kbcola/linetracer_D4/makeTracer/circuit/sensorgensun.pdf

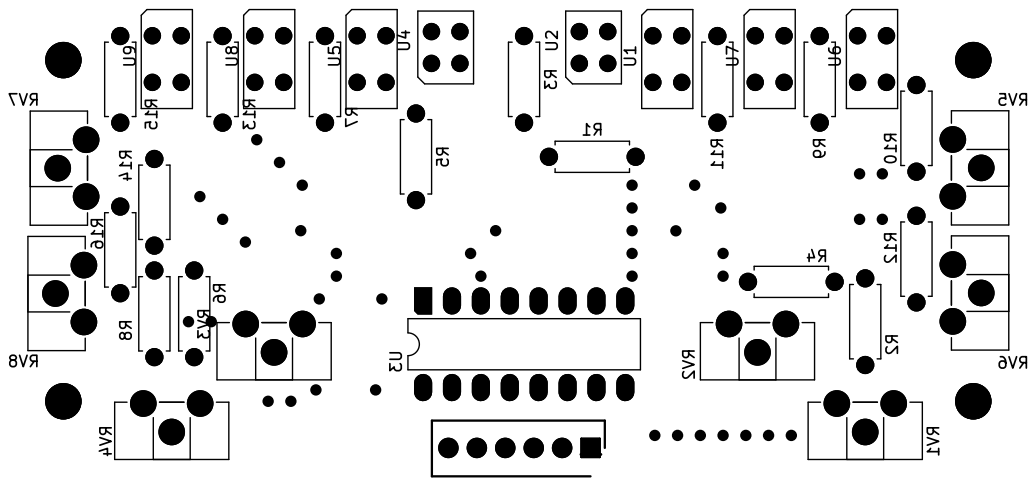
[picture p1: page 1]
