kbcola/linetracer_D4/makeTracer/circuit/factoryData/maincircuit.pdf

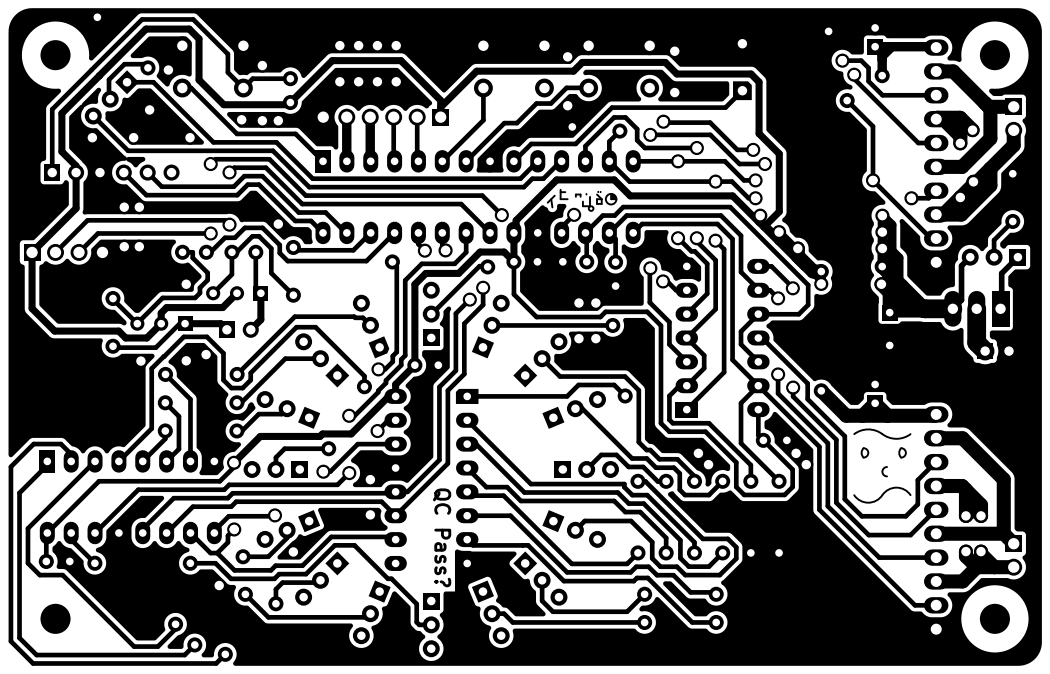
[picture p2: page 1]
