kbcola/linetracer_D4/makeTracer/circuit/factoryData/sensorcircuit.pdf

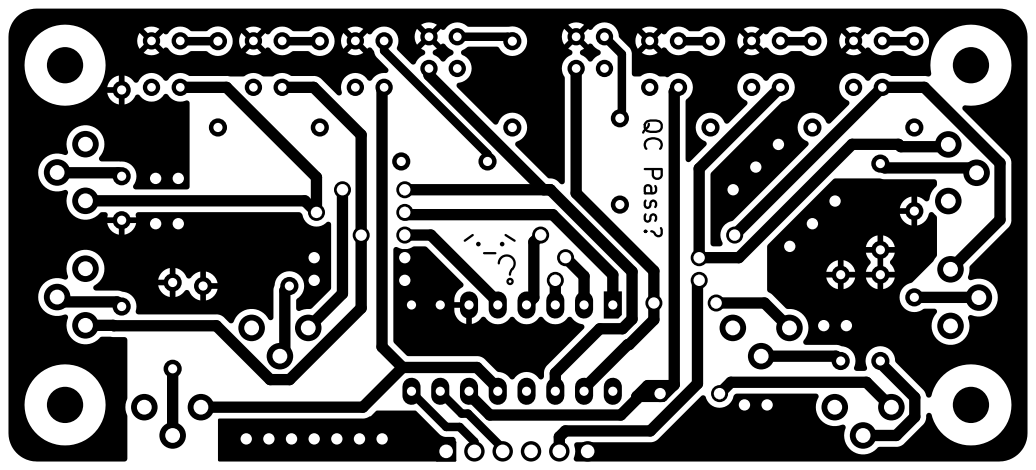
[picture p3: page 1]
