kbcola/linetracer_D4/makeTracer/circuit/maincircuit/output.pdf

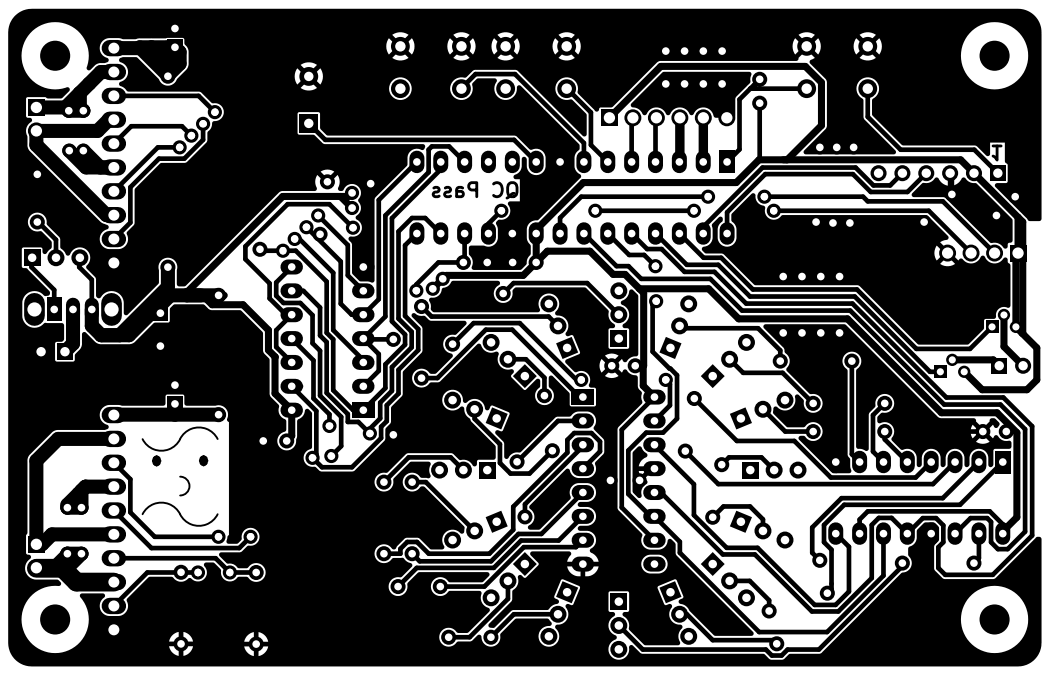
[picture p4: page 1]
