kbcola/linetracer_D4/makeTracer/circuit/sregtest/sregtest.kicad_pcb

## KiCad design Hardware/arcus_detector/arcus_detector.kicad_sch

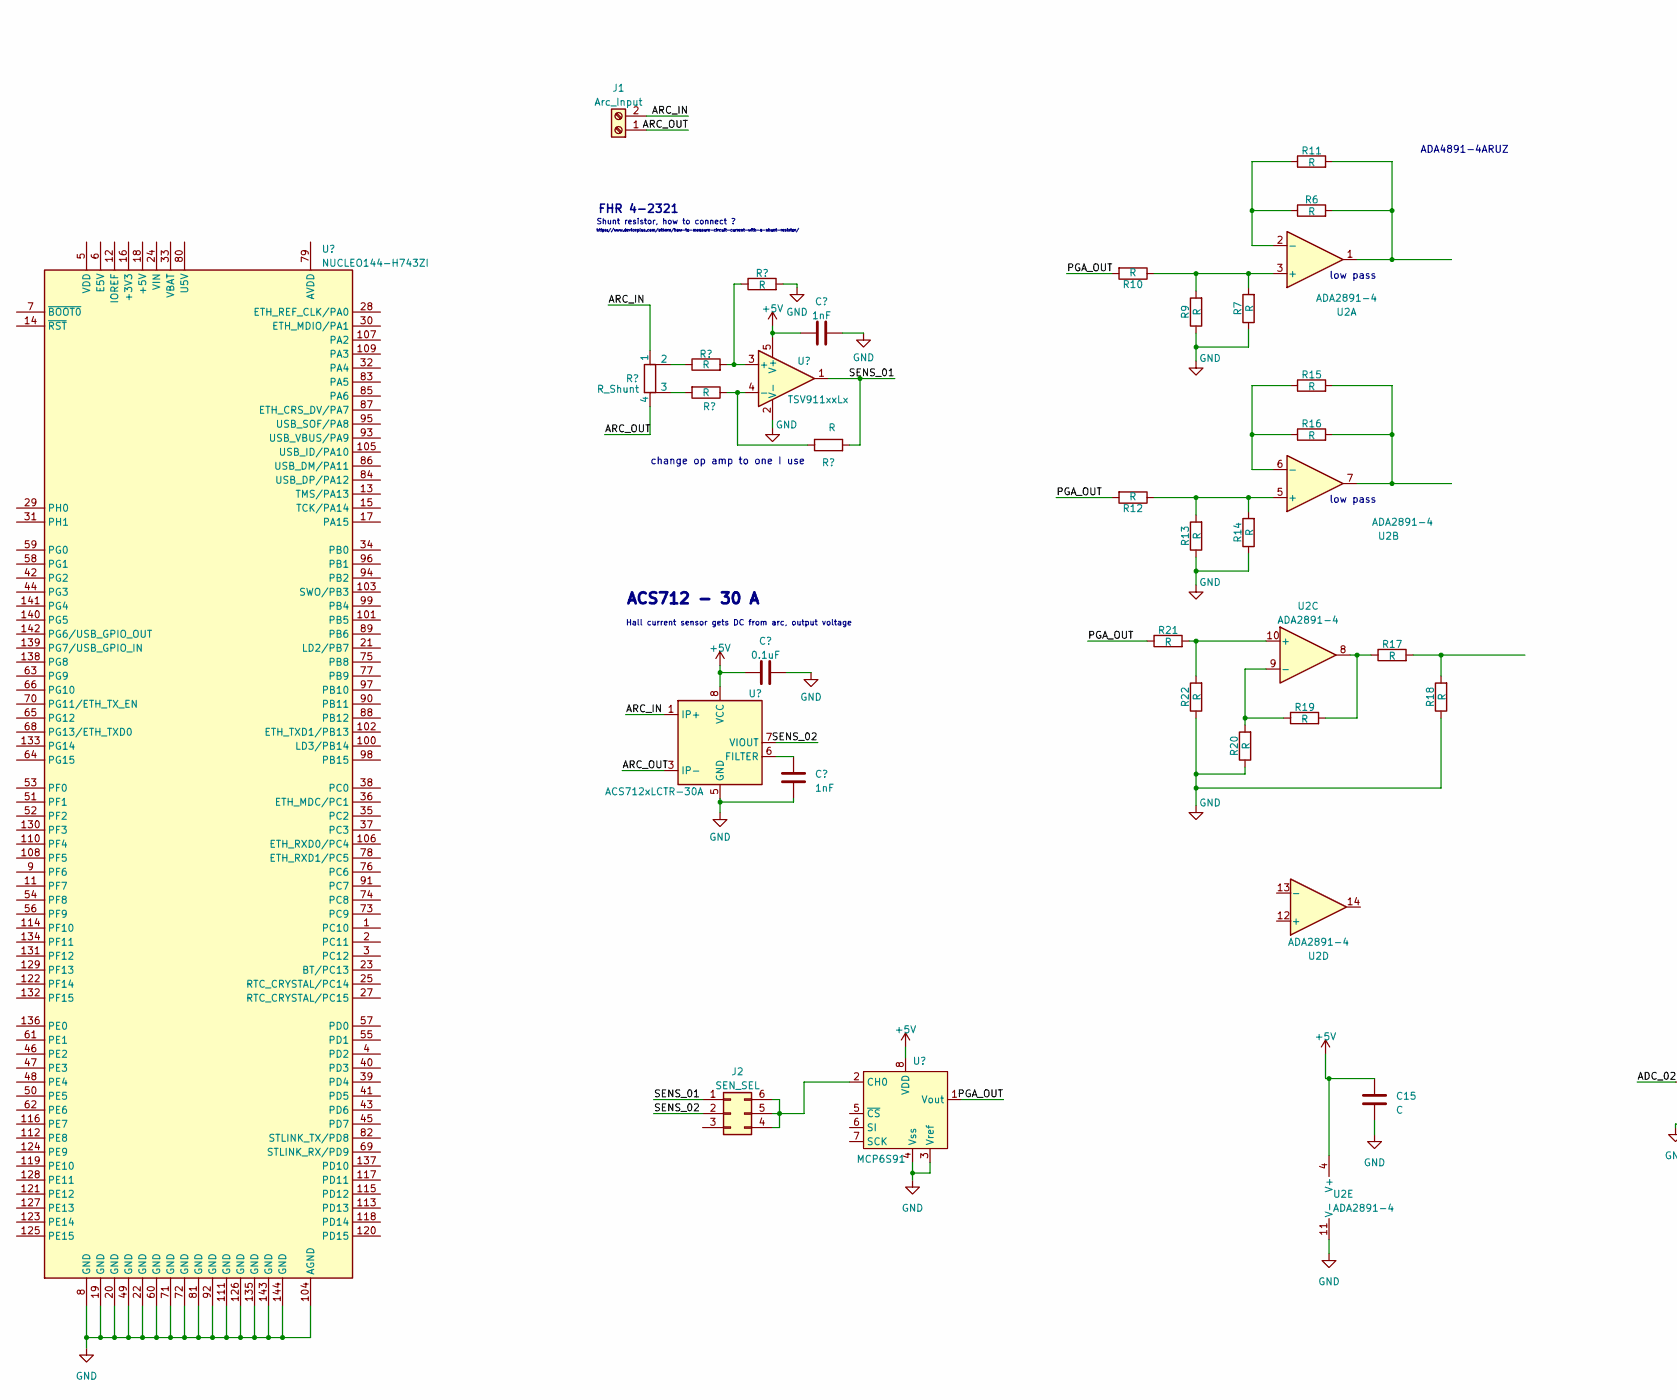
[picture p5: schematic arcus_detector.kicad_sch, part in row 1, column 1]

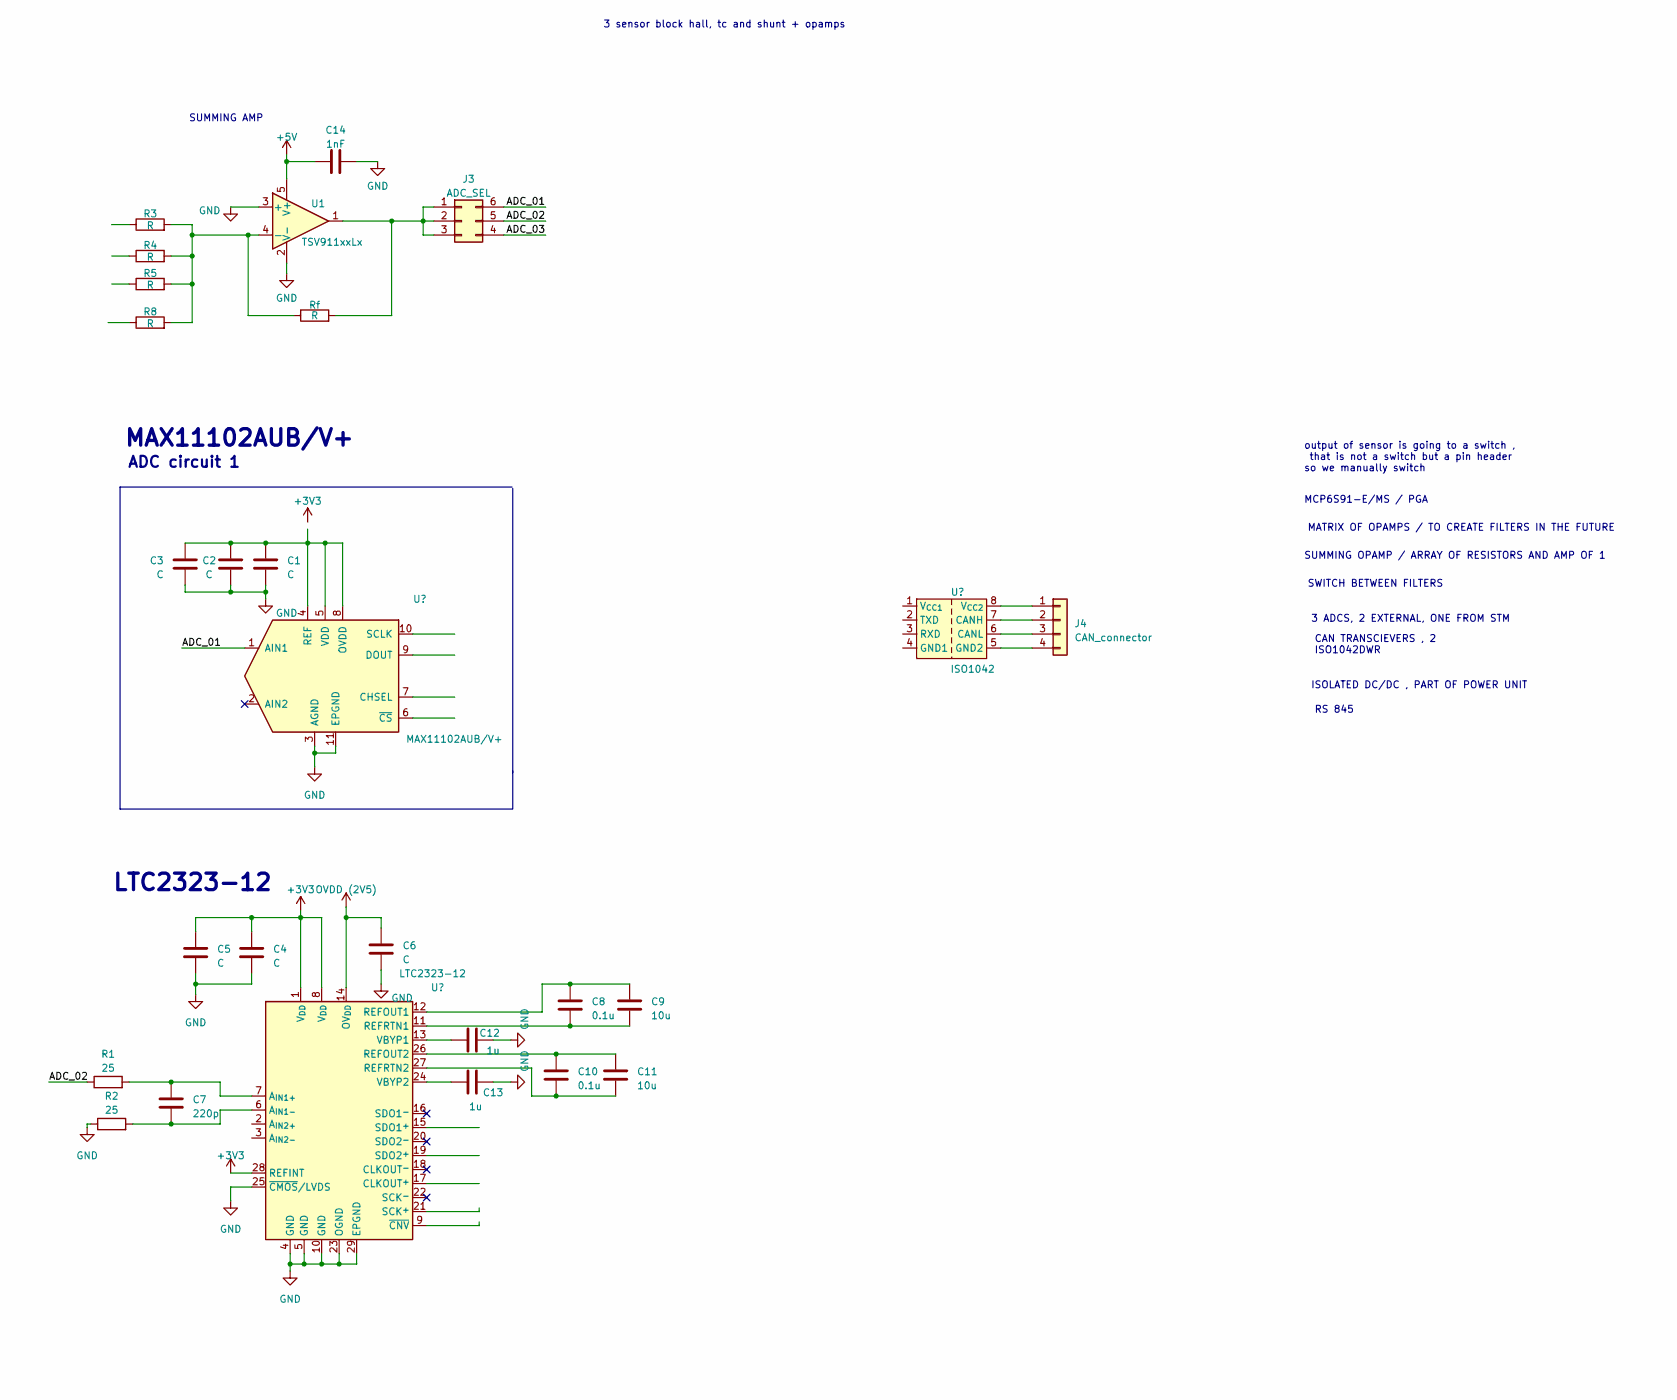
[picture p6: schematic arcus_detector.kicad_sch, part in row 1, column 2]

Parts:
C1, C2, C3, C4, C5, C6, C15: C
C7: 220p
C8, C10: 0.1u
C9, C11: 10u
C12, C13: 1u
C14: 1nF
J1: Arc_Input
J2: SEN_SEL
J3: ADC_SEL
J4: CAN_connector
R1, R2: 25
R3, R4, R5, R6, R7, R8, R9, R10, R11, R12, R13, R14, R15, R16, R17, R18, R19, R20, R21, R22: R
Rf: R
U1: TSV911xxLx; SOT-23-5
U2: ADA2891-4; TSSOP-14_4.4x5mm_P0.65mm

Connections:
+3V3: C4.1, C5.1
+5V: C14.1, C15.1, U1.5 (V+), U2.4 (V+)
ADC_01: J3.6
ADC_02: J3.5, R1.1
ADC_03: J3.4
ARC_IN: J1.2
ARC_OUT: J1.1
GND: C1.2, C2.2, C3.2, C4.2, C5.2, C6.2, C12.2, C13.2, C14.2, C15.2, R2.1, R7.1, R9.1, R13.1, R14.1, R18.1, R20.1, R22.1, U1.2 (V-), U1.3 (+), U2.11 (V-)
unnamed: C1.1, C2.1, C3.1
unnamed: C7.1, R1.2
unnamed: C7.2, R2.2
unnamed: C8.1, C9.1
unnamed: C8.2, C9.2
unnamed: C10.1, C11.1
unnamed: C10.2, C11.2
unnamed: J2.4, J2.5, J2.6
unnamed: J3.1, J3.2, J3.3, Rf.2, U1.1
unnamed: R3.2, R4.2, R5.2, R8.2, Rf.1, U1.4 (-)
unnamed: R7.2, R9.2, R10.1, U2.3 (+)
unnamed: R6.1, R11.1, U2.2 (-)
unnamed: R6.2, R11.2, U2.1
unnamed: R12.1, R13.2, R14.2, U2.5 (+)
unnamed: R15.1, R16.1, U2.6 (-)
unnamed: R15.2, R16.2, U2.7
unnamed: R17.1, R19.2, U2.8
unnamed: R17.2, R18.2
unnamed: R19.1, R20.2, U2.9 (-)
unnamed: R21.2, R22.2, U2.10 (+)
OVDD (2V5): C6.1
PGA_OUT: R10.2, R12.2, R21.1
SENS_01: J2.1
SENS_02: J2.2

Notes on the sheet:
https://www.deviceplus.com/others/how-to-measure-circuit-current-with-a-shunt-resistor/
change op amp to one I use
RS 845
MAX11102AUB/V+
ADC circuit 1
Hall current sensor gets DC from arc, output voltage
ADA4891-4ARUZ
CAN TRANSCIEVERS , 2 ISO1042DWR
SUMMING AMP
MATRIX OF OPAMPS / TO CREATE FILTERS IN THE FUTURE
MCP6S91-E/MS / PGA
SUMMING OPAMP / ARRAY OF RESISTORS AND AMP OF 1
ACS712 - 30 A
LTC2323-12
low pass
ISOLATED DC/DC , PART OF POWER UNIT
3 sensor block hall, tc and shunt + opamps
output of sensor is going to a switch , that is not a switch but a pin header so we manually switch
SWITCH BETWEEN FILTERS
FHR 4-2321
Shunt resistor, how to connect ?
3 ADCS, 2 EXTERNAL, ONE FROM STM
