kbcola/linetracer_D4/makeTracer/circuit/sregtest/sregtest.kicad_pcb

## KiCad design Hardware/arcus_detector/untitled.kicad_sch

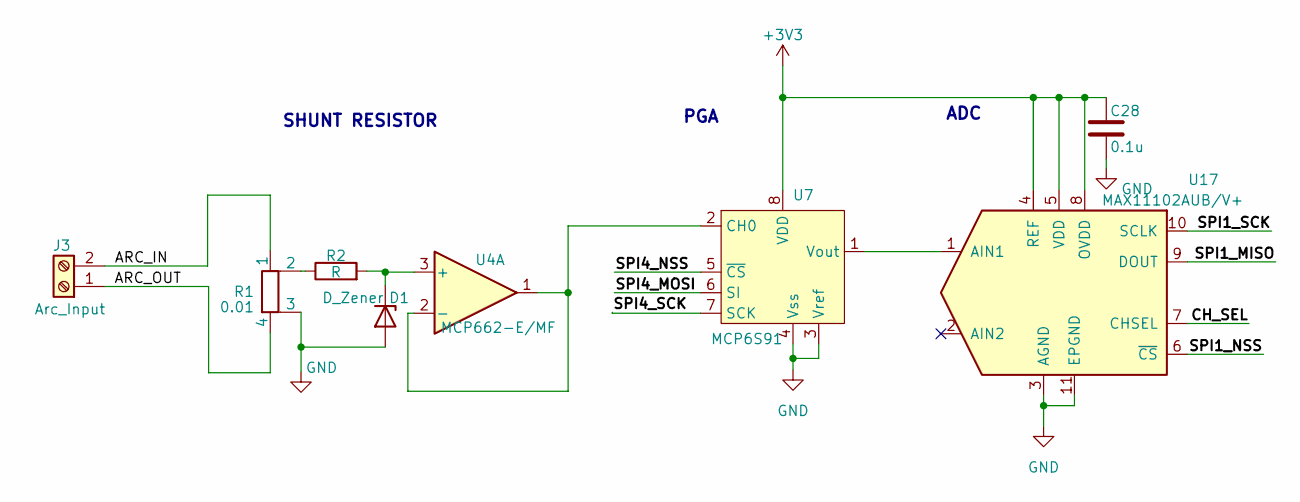
[picture p7: schematic untitled.kicad_sch]

Parts:
C28: 0.1u
D1: D_Zener
J3: Arc_Input
R1: 0.01
R2: R
U4: MCP662-E/MF; SOIC-8_3.9x4.9mm_P1.27mm
U7: MCP6S91
U17: MAX11102AUB/V+

Connections:
+3V3: C28.1, U7.8 (VDD), U17.4 (REF), U17.5 (VDD), U17.8 (OVDD)
ARC_IN: J3.2, R1.1
ARC_OUT: J3.1, R1.4
CH_SEL: U17.7 (CHSEL)
GND: C28.2, D1.2 (A), R1.3, U7.3 (Vref), U7.4 (Vss), U17.3 (AGND), U17.11 (EPGND)
unnamed: D1.1 (K), R2.2, U4.3 (+)
unnamed: R1.2, R2.1
unnamed: U4.1, U4.2 (-), U7.2 (CH0)
unnamed: U7.1 (Vout), U17.1 (AIN1)
SPI1_MISO: U17.9 (DOUT)
SPI1_NSS: U17.6 (~CS)
SPI1_SCK: U17.10 (SCLK)
SPI4_MOSI: U7.6 (SI)
SPI4_NSS: U7.5 (~CS)
SPI4_SCK: U7.7 (SCK)

Notes on the sheet:
PGA
SHUNT RESISTOR
ADC
