kbcola/linetracer_D4/firstTracer/ciruit/ciruit.kicad_sch

## KiCad design firstTracer/ciruit/ciruit.kicad_sch (2023-06-26)

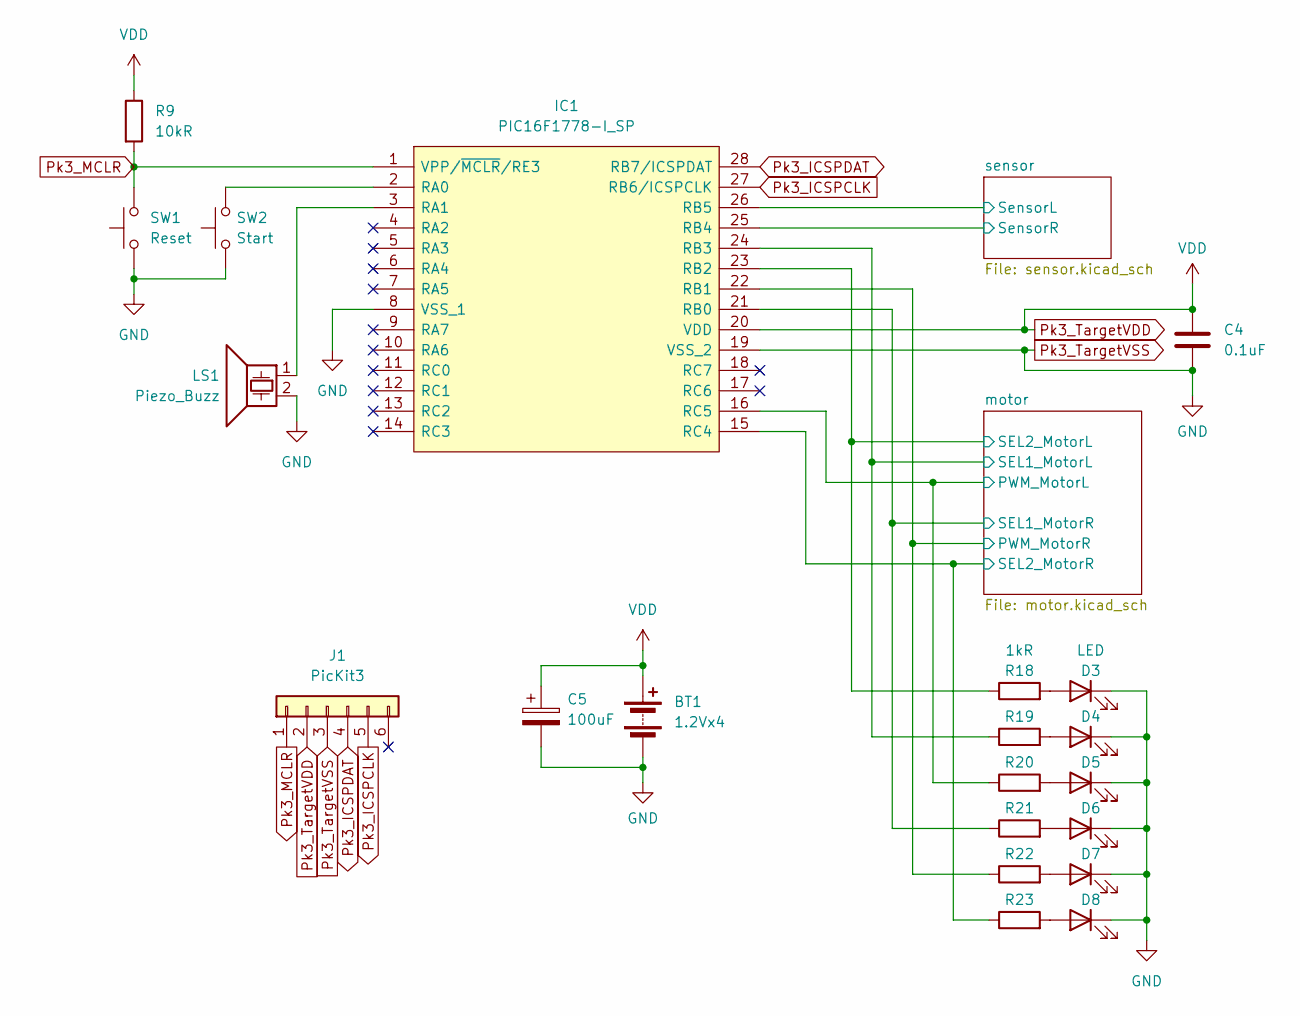
[picture p8: schematic ciruit.kicad_sch]

Parts:
BT1: 1.2Vx4
C4: 0.1uF
C5: 100uF
D3, D4, D5, D6, D7, D8: LED
IC1: PIC16F1778-I_SP; DIP794W56P254L3486H508Q28N; Manufacturer_Part_Number PIC16F1778-I/SP
J1: PicKit3
LS1: Piezo_Buzz; Buzzer_12x9.5RM7.6
R9: 10kR
R18, R19, R20, R21, R22, R23: 1kR
SW1: Reset
SW2: Start

Connections:
GND: BT1.2 (-), C4.2, C5.2, D3.1 (K), D4.1 (K), D5.1 (K), D6.1 (K), D7.1 (K), D8.1 (K), IC1.8 (VSS_1), IC1.19 (VSS_2), J1.3, LS1.2, SW1.1, SW2.1
unnamed: D3.2 (A), R18.2
unnamed: D4.2 (A), R19.2
unnamed: D5.2 (A), R20.2
unnamed: D6.2 (A), R21.2
unnamed: D7.2 (A), R22.2
unnamed: D8.2 (A), R23.2
unnamed: IC1.2 (RA0), SW2.2
unnamed: IC1.3 (RA1), LS1.1
PWM_MotorL: IC1.16 (RC5), R20.1
PWM_MotorR: IC1.22 (RB1), R22.1
Pk3_ICSPCLK: IC1.27 (RB6/ICSPCLK), J1.5
Pk3_ICSPDAT: IC1.28 (RB7/ICSPDAT), J1.4
Pk3_MCLR: IC1.1 (VPP/~MCLR/RE3), J1.1, R9.2, SW1.2
Pk3_TargetVDD: BT1.1 (+), C4.1, C5.1, IC1.20 (VDD), J1.2, R9.1
SEL1_MotorL: IC1.24 (RB3), R19.1
SEL1_MotorR: IC1.21 (RB0), R21.1
SEL2_MotorL: IC1.23 (RB2), R18.1
SEL2_MotorR: IC1.15 (RC4), R23.1
SensorL: IC1.26 (RB5)
SensorR: IC1.25 (RB4)
