kbcola/linetracer_D4/firstTracer/ciruit/motor.kicad_sch

## KiCad design firstTracer/ciruit/motor.kicad_sch (2023-06-26)

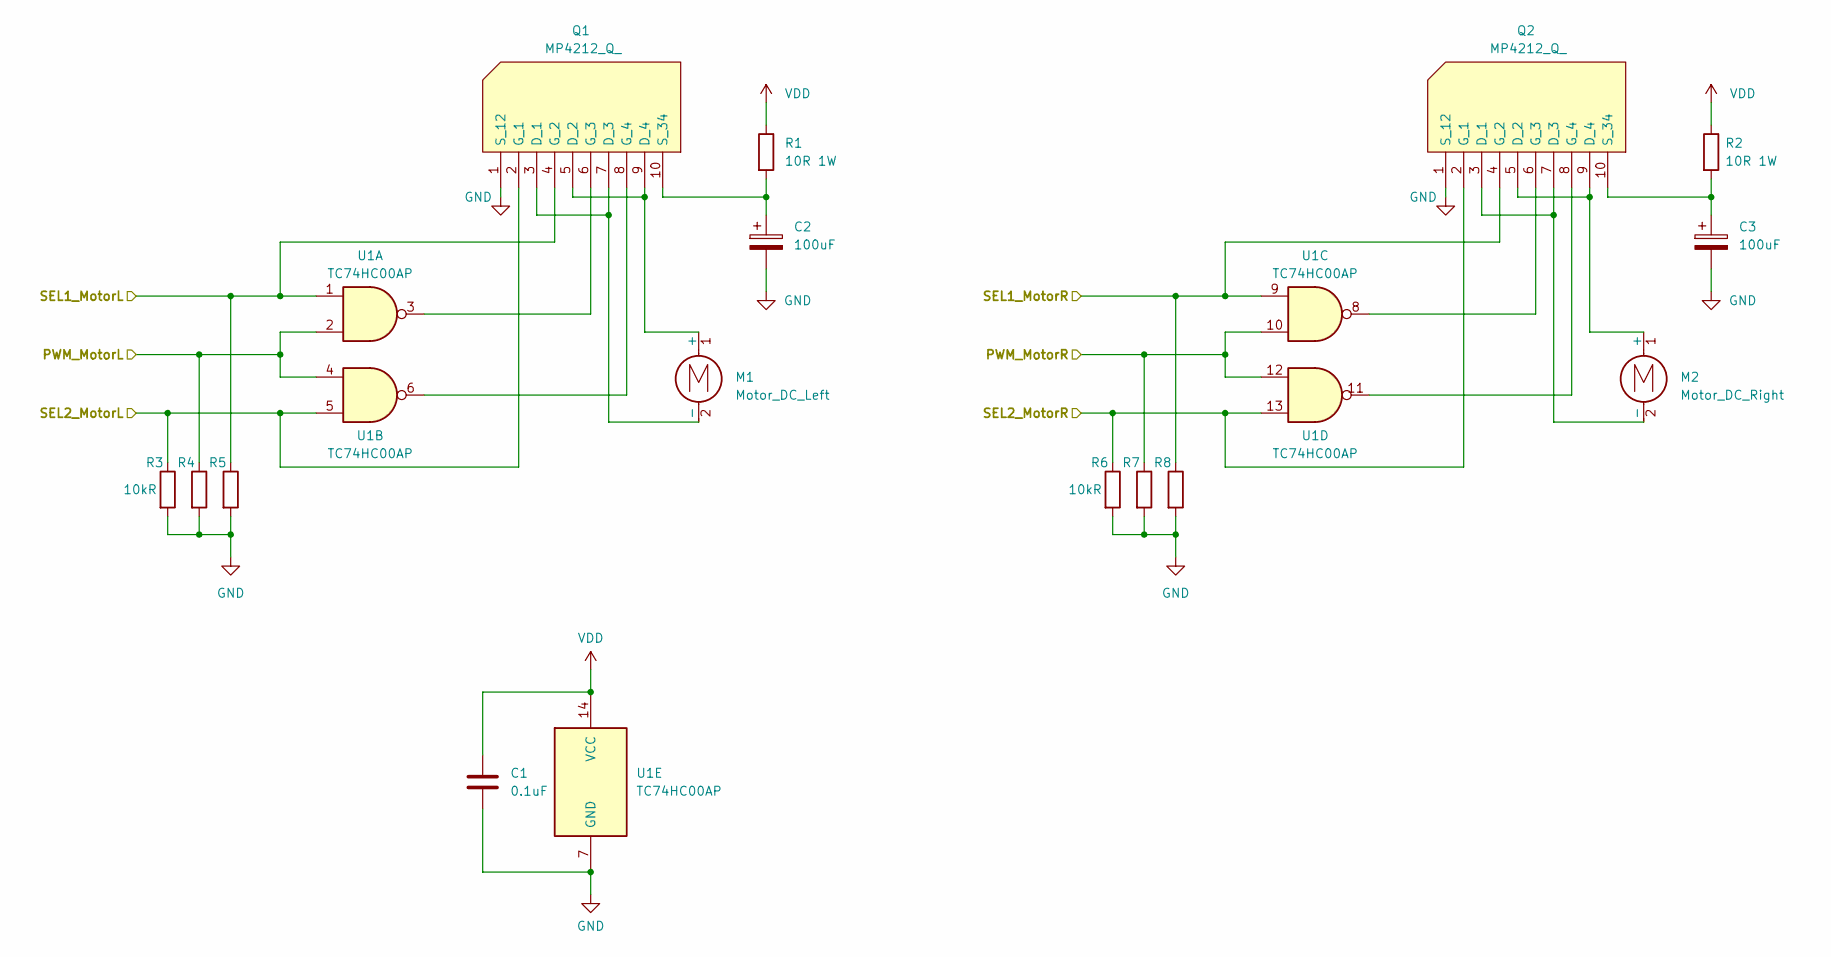
[picture p9: schematic motor.kicad_sch]

Parts:
C1: 0.1uF
C2, C3: 100uF
M1: Motor_DC_Left
M2: Motor_DC_Right
Q1, Q2: MP4212_Q_; MP4212Q; Manufacturer_Part_Number MP4212(Q)
R1, R2: 10R 1W
R3, R6: 10kR
R4, R5, R7, R8: 10kΩ
U1: TC74HC00AP

Connections:
GND: C1.2, C2.2, C3.2, Q1.1 (S_12), Q2.1 (S_12), R3.2, R4.2, R5.2, R6.2, R7.2, R8.2, U1.7 (GND)
unnamed: C2.1, Q1.10 (S_34), R1.2
unnamed: C3.1, Q2.10 (S_34), R2.2
unnamed: M1.1 (+), Q1.5 (D_2), Q1.9 (D_4)
unnamed: M1.2 (-), Q1.3 (D_1), Q1.7 (D_3)
unnamed: M2.1 (+), Q2.5 (D_2), Q2.9 (D_4)
unnamed: M2.2 (-), Q2.3 (D_1), Q2.7 (D_3)
unnamed: Q1.6 (G_3), U1.3
unnamed: Q1.8 (G_4), U1.6
unnamed: Q2.6 (G_3), U1.8
unnamed: Q2.8 (G_4), U1.11
PWM_MotorL: R4.1, U1.2, U1.4
PWM_MotorR: R7.1, U1.10, U1.12
SEL1_MotorL: Q1.4 (G_2), R5.1, U1.1
SEL1_MotorR: Q2.4 (G_2), R8.1, U1.9
SEL2_MotorL: Q1.2 (G_1), R3.1, U1.5
SEL2_MotorR: Q2.2 (G_1), R6.1, U1.13
VDD: C1.1, R1.1, R2.1, U1.14 (VCC)
