kbcola/linetracer_D4/firstTracer/ciruit/sensor.kicad_sch

## KiCad design firstTracer/ciruit/sensor.kicad_sch (2023-06-18)

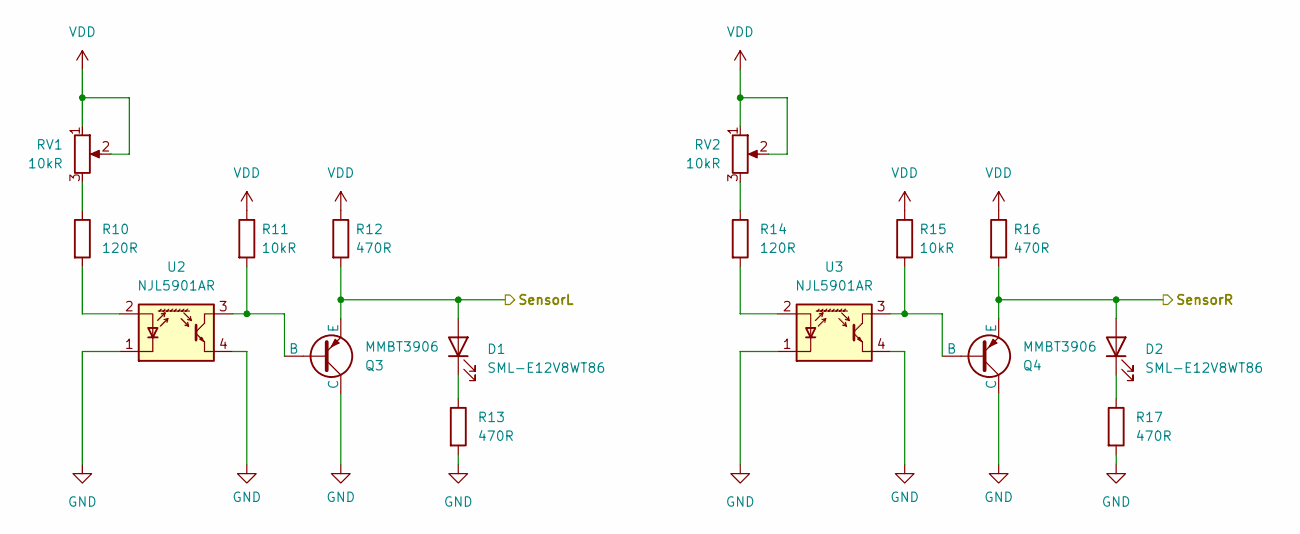
[picture p10: schematic sensor.kicad_sch]

Parts:
D1, D2: SML-E12V8WT86
Q3, Q4: MMBT3906
R10, R14: 120R
R11, R15: 10kR
R12, R13, R16, R17: 470R
RV1, RV2: 10kR
U2, U3: NJL5901AR; Everlight_ITR8307

Connections:
GND: Q3.1 (C), Q4.1 (C), R13.2, R17.2, U2.1 (K), U2.4 (E), U3.1 (K), U3.4 (E)
unnamed: D1.1 (K), R13.1
unnamed: D2.1 (K), R17.1
unnamed: Q3.2 (B), R11.2, U2.3 (C)
unnamed: Q4.2 (B), R15.2, U3.3 (C)
unnamed: R10.1, RV1.3
unnamed: R10.2, U2.2 (A)
unnamed: R14.1, RV2.3
unnamed: R14.2, U3.2 (A)
SensorL: D1.2 (A), Q3.3 (E), R12.2
SensorR: D2.2 (A), Q4.3 (E), R16.2
VDD: R11.1, R12.1, R15.1, R16.1, RV1.1, RV1.2, RV2.1, RV2.2
