kbcola/linetracer_D4/makeTracer/linetracer_oval_moved.X/directLED.h

/* 
 * File:   directLED.h
 * Author: seikin
 *
 * Created on September 22, 2023, 3:39 PM
 */

#ifndef DIRECTLED_H
#define	DIRECTLED_H

#ifdef	__cplusplus
extern "C" {
#endif

    void onG(void);
    
    void onR(void);
    
    void offG(void);
    
    void offR(void);
    
    void flipDL(void);

#ifdef	__cplusplus
}
#endif

#endif	/* DIRECTLED_H */
