kbcola/linetracer_D4/(commit log)

2023-06-18 jikken2: make circuit
    [ciruit.kicad_pcb, ciruit.kicad_sch, motor.kicad_sch, sensor.kicad_sch]
2023-06-18 jikken2: fix circuit
    [ciruit.kicad_sch, motor.kicad_sch, sensor.kicad_sch]
2023-07-11 comparator ugokan
    [ciruit.kicad_pcb, ciruit.kicad_sch, motor.kicad_sch, sensor.kicad_sch]
2023-08-21 done: maincircuit
    [16x2LEDs.kicad_sch, maincircuit.kicad_pcb, maincircuit.kicad_sch, motordrive.kicad_sch]
2023-08-22 fix: yabai jumper
    [16x2LEDs.kicad_sch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]
2023-08-22 great wip
    [sensorcircuit.kicad_pcb, sensorcircuit.kicad_sch]
2023-08-23 add: sensors and etc.
2023-08-25 wrong size! fooo
    [ledcircuit.kicad_pcb, ledcircuit.kicad_sch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]
2023-09-11 complete: circuit
    [16x2LEDs.kicad_sch, ciruit.kicad_sch, maincircuit.kicad_pcb, maincircuit.kicad_sch, motor.kicad_sch, motordrive.kicad_sch, sensorcircuit.kicad_pcb]
2023-09-12 fix: .2mm to .4mm
    [16x2LEDs.kicad_sch, maincircuit.kicad_pcb, maincircuit.kicad_sch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]
2023-09-19 wip kamo shiren na(´･_･`)
    [sregtest.kicad_pcb, sregtest.kicad_sch]
2023-09-22 fix: SW interrupt
2023-09-22 add: sensor
2023-09-22 fuck fuck fuck: motordriver
